ji1xuy/WattMonitor/実体配線図_表面.jpg

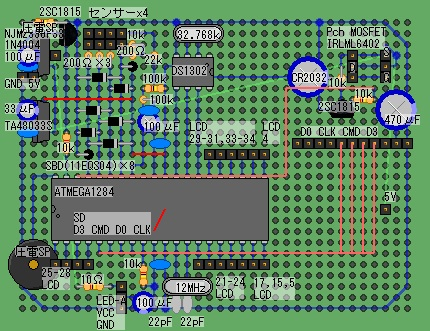
実体配線図_表面.jpg
