ji1xuy/WattMonitor/実体配線図_裏面.jpg

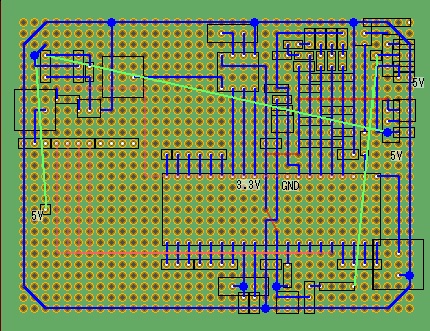
実体配線図_裏面.jpg
