ji1xuy/WattMonitor/powersupply_20250811.jpg

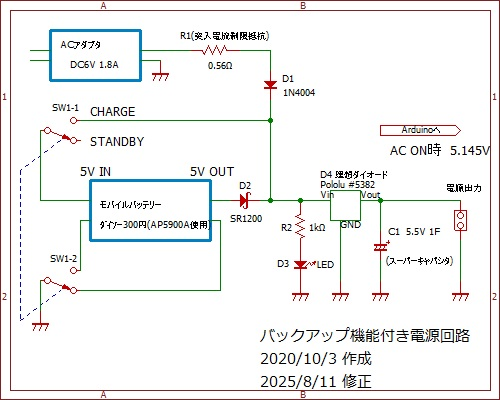
powersupply_20250811.jpg
