ji1xuy/WattMonitor/メイン回路_Aitendo_LCD.jpg

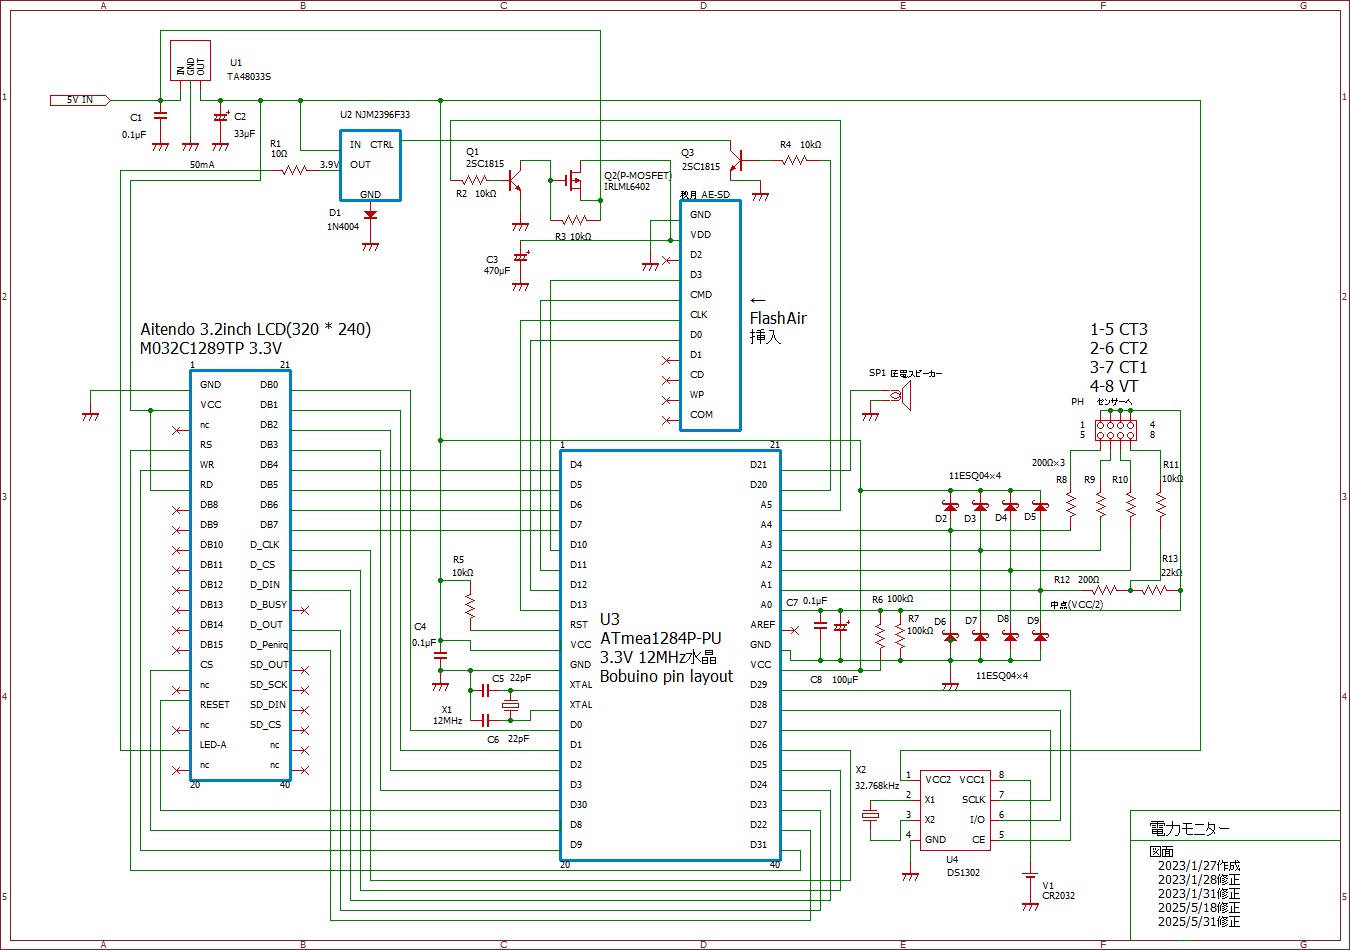
メイン回路_Aitendo_LCD.jpg
